X1-McFly/Sim_BCI/old/notes/schematic.pdf

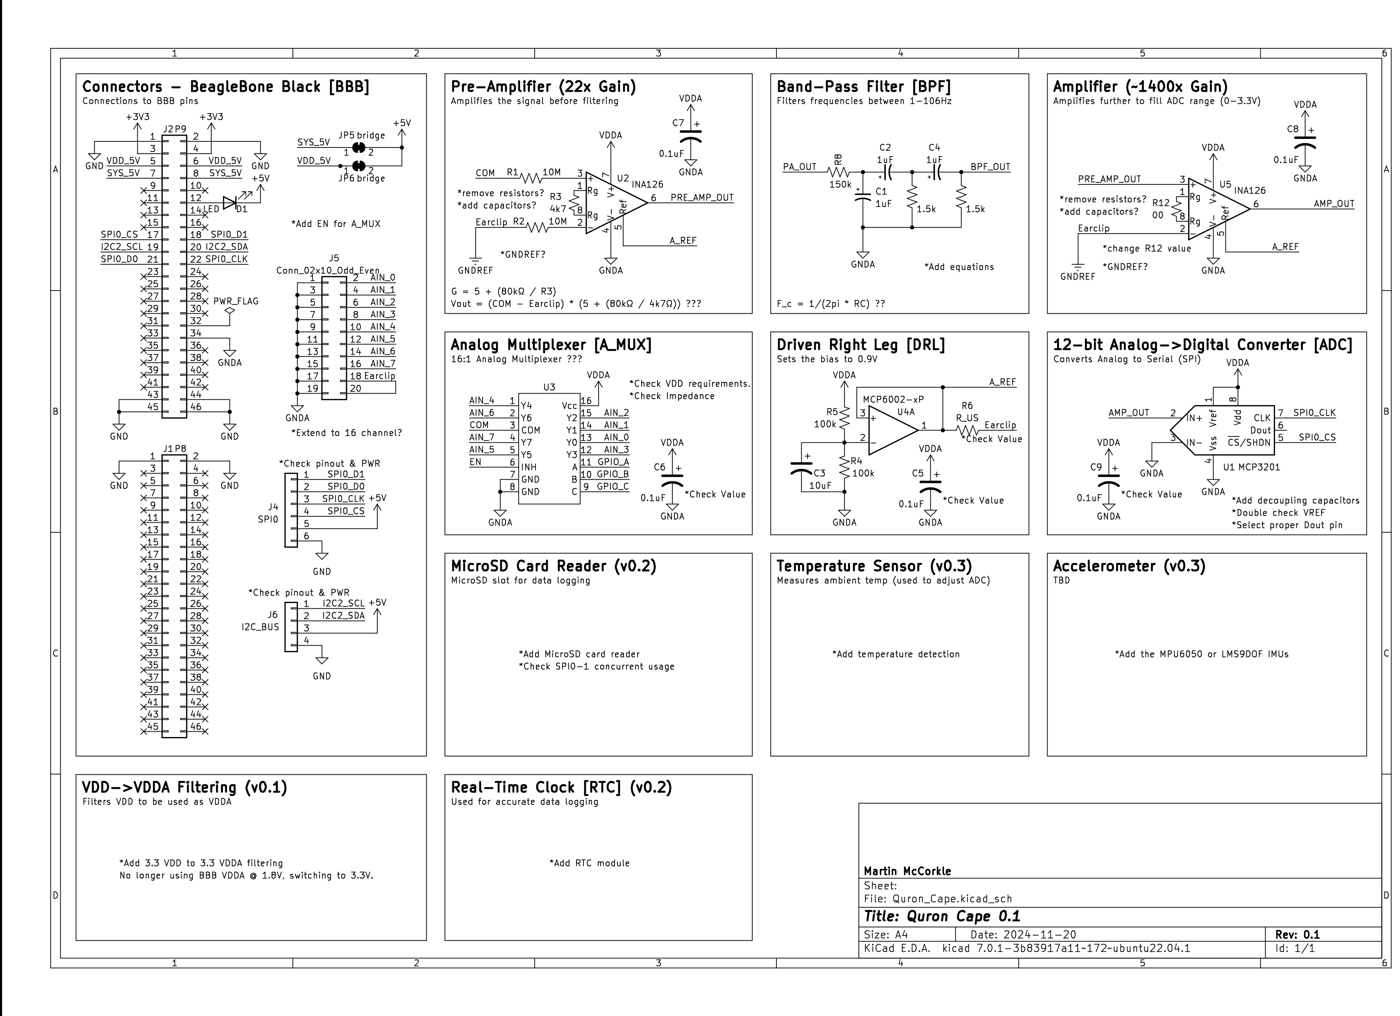
[picture p28: page 1]
