X1-McFly/Sim_BCI/old/hardware/Quron_Capev1/doc/output.pdf

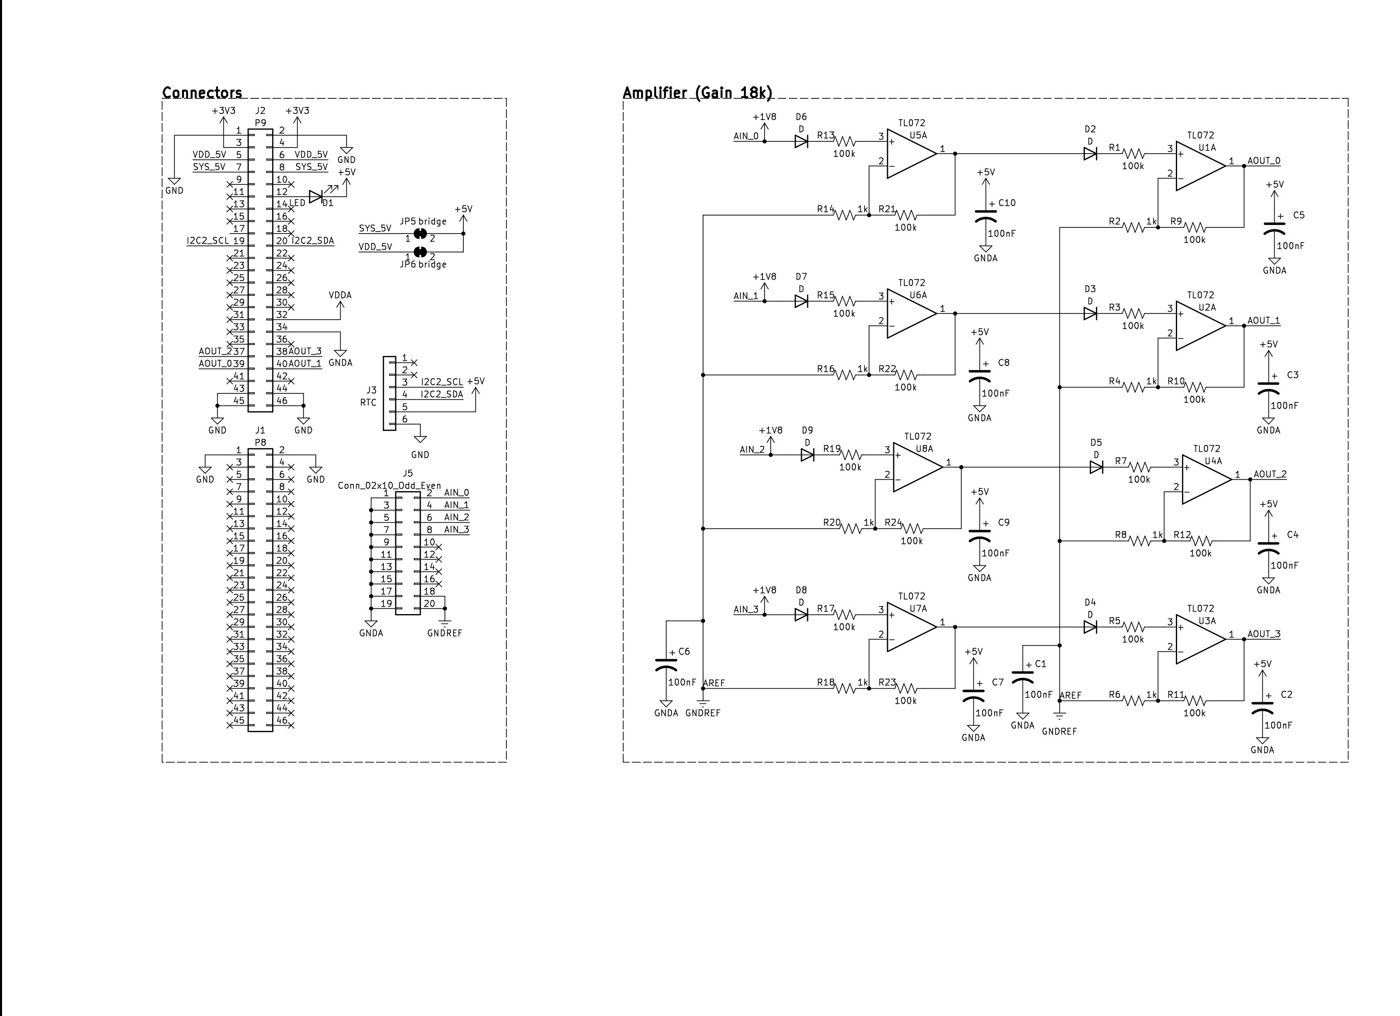
[picture p29: page 1]
