X1-McFly/Sim_BCI/old/hardware/Quron_Capev1/doc/schematic_v1-1.pdf

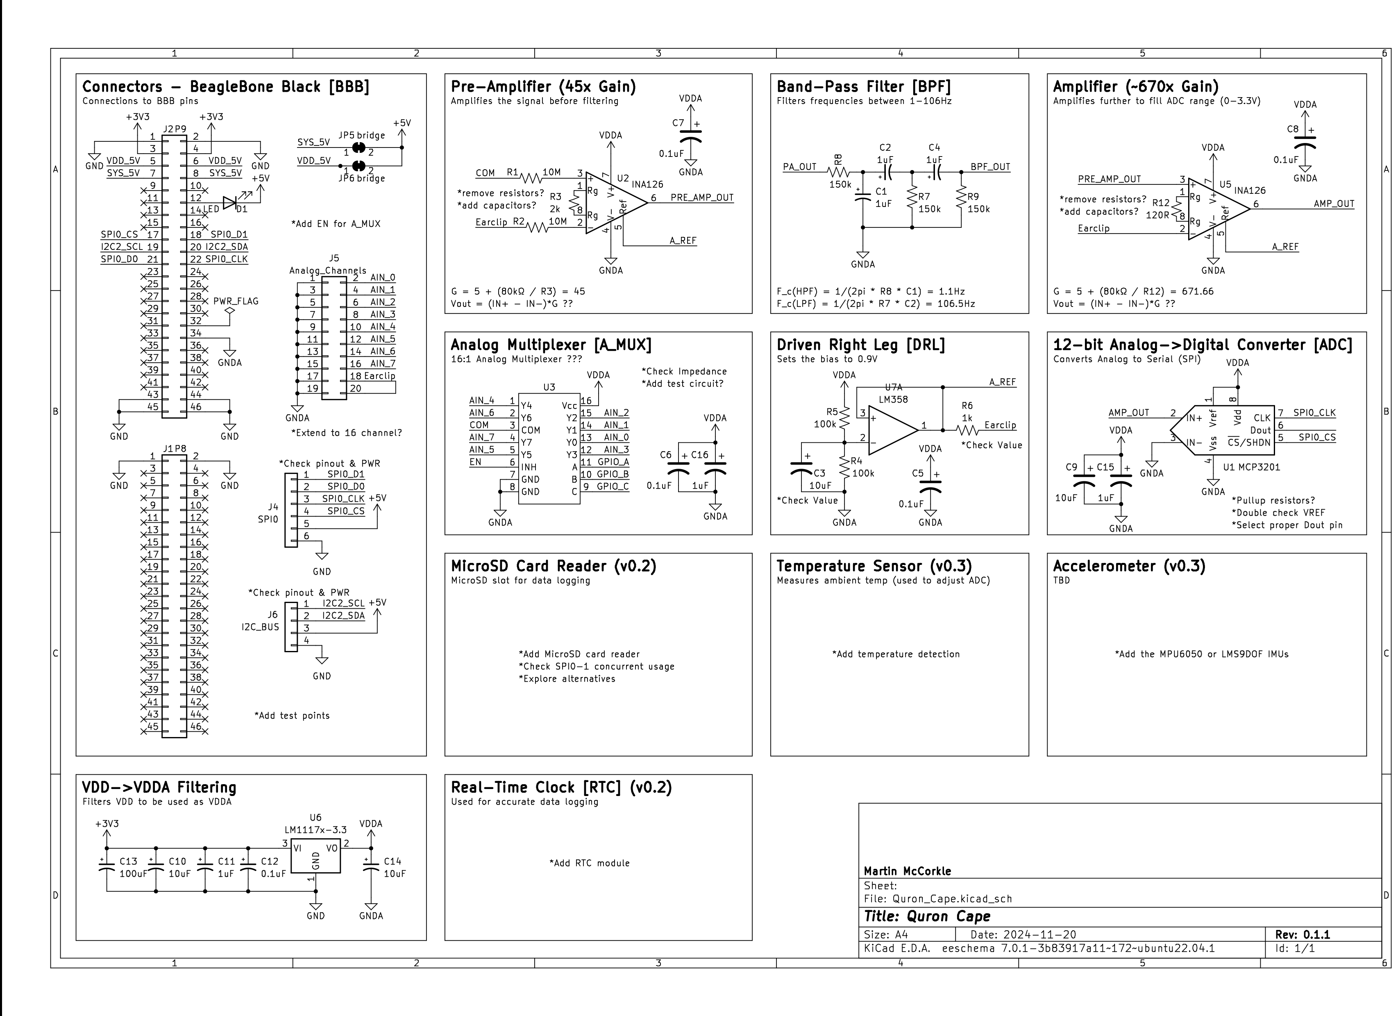
[picture p30: page 1]
