X1-McFly/Sim_BCI/old/hardware/Quron_Capev1/bms/BMS v0.1/output.pdf

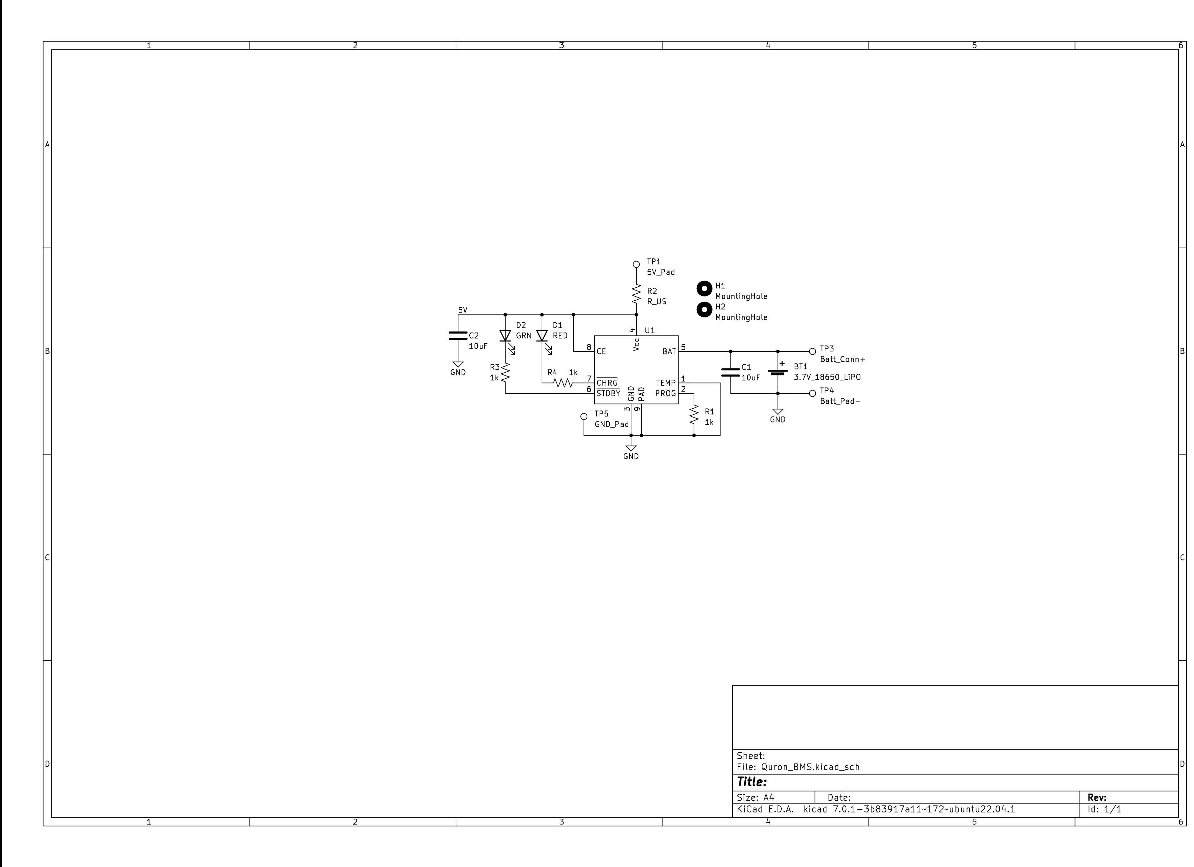
[picture p31: page 1]
