X1-McFly/Sim_BCI/doc/report(11-10-2024)/circuit1.png

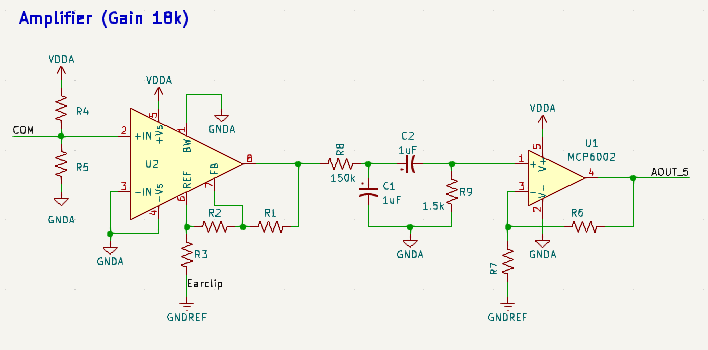
doc/report(11-10-2024)/circuit1.png
