X1-McFly/Sim_BCI/doc/report(11-25-2024)/img/spice-scrnsht(10-14-2024).png

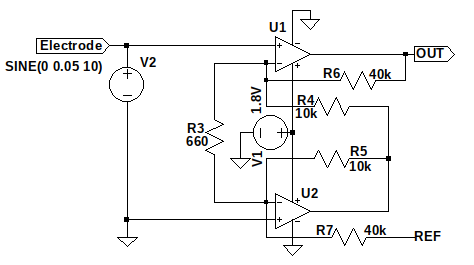
doc/report(11-25-2024)/img/spice-scrnsht(10-14-2024).png
