X1-McFly/Sim_BCI/doc/report(11-25-2024)/oscillo(10-25-24)/TEK00003.PNG

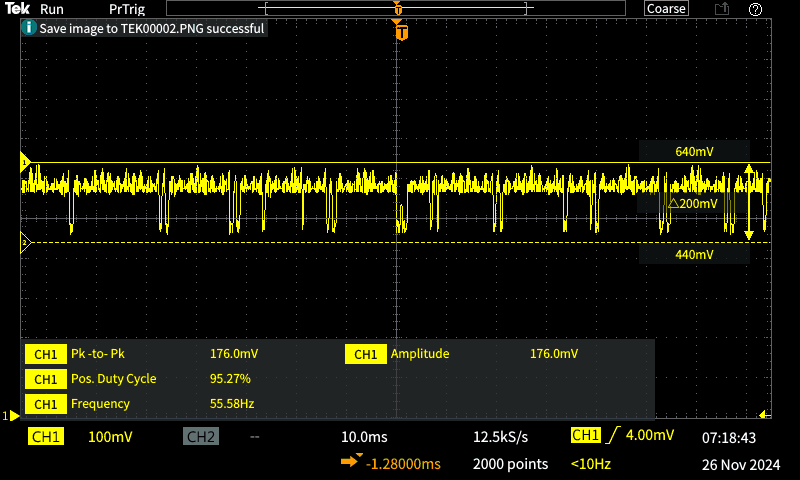
doc/report(11-25-2024)/oscillo(10-25-24)/TEK00003.PNG
