X1-McFly/Sim_BCI/doc/report(12-23-2024)/img/TEK00001.PNG

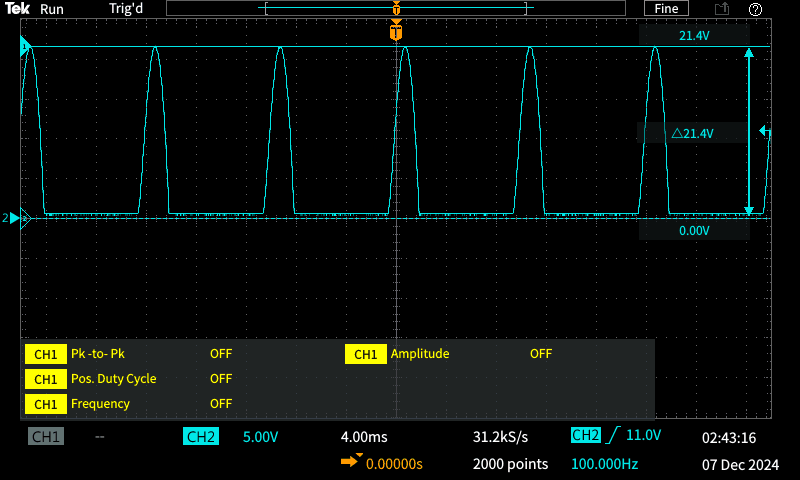
doc/report(12-23-2024)/img/TEK00001.PNG
