X1-McFly/Sim_BCI/doc/report(12-23-2024)/img/TEK00002.PNG

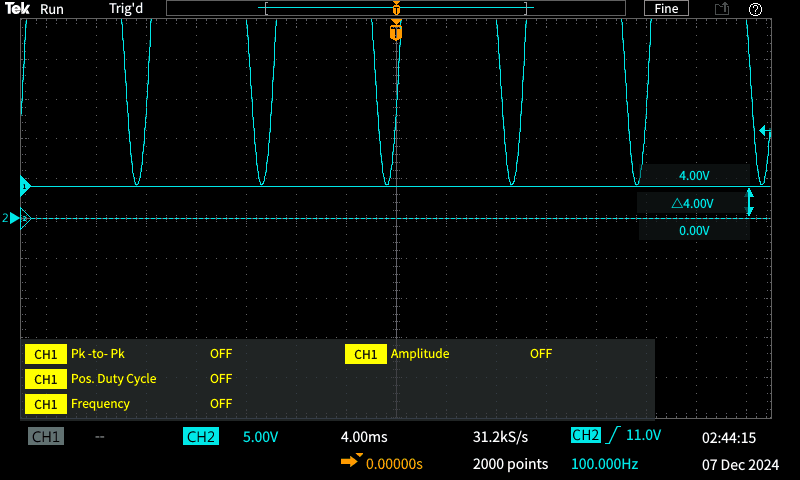
doc/report(12-23-2024)/img/TEK00002.PNG
