X1-McFly/Sim_BCI/img/alpha_fft_vs_steering.png

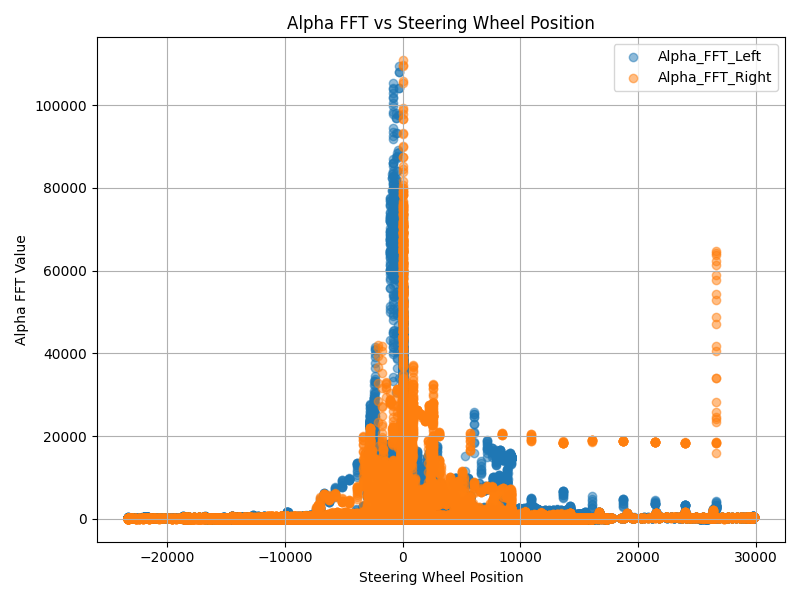
img/alpha_fft_vs_steering.png
