X1-McFly/Sim_BCI/img/eeg_fft_vs_steering_correlation.png

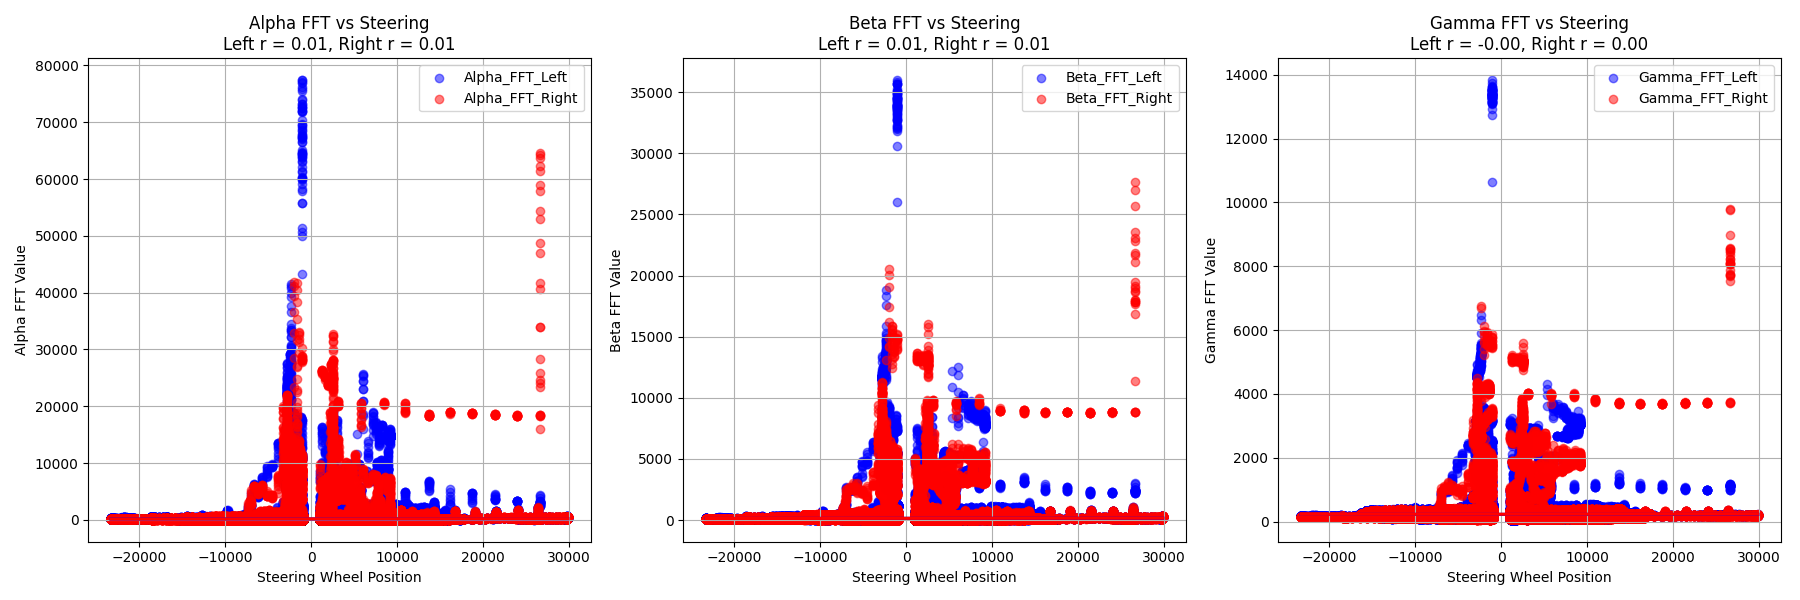
img/eeg_fft_vs_steering_correlation.png
