X1-McFly/Sim_BCI/img/electrode_placement1.png

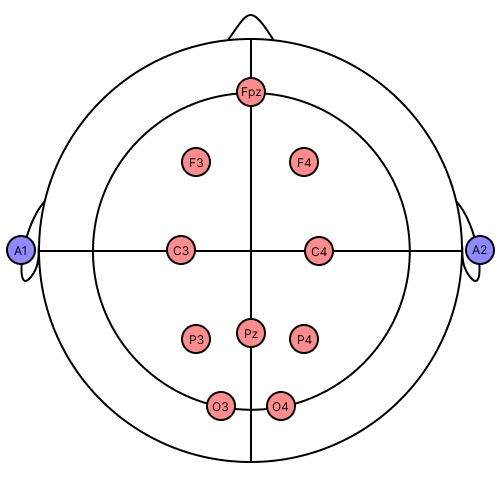
img/electrode_placement1.png
