X1-McFly/Sim_BCI/img/Figure_1.png

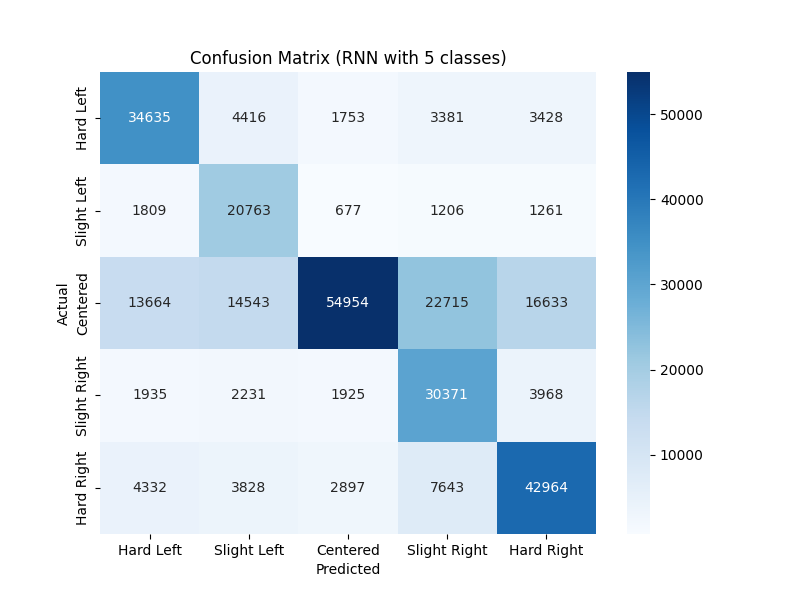
img/Figure_1.png
