X1-McFly/Sim_BCI/img/gamma_fft_vs_steering.png

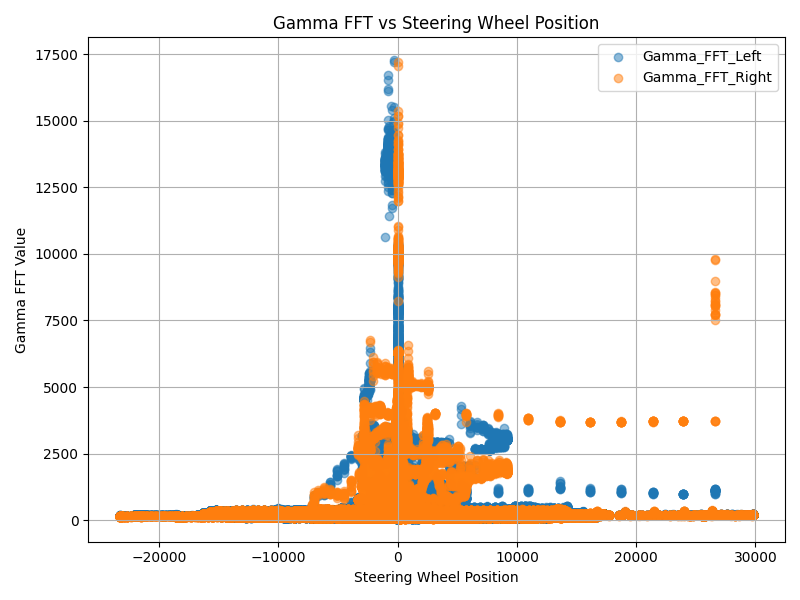
img/gamma_fft_vs_steering.png
