X1-McFly/Sim_BCI/img/plot.png

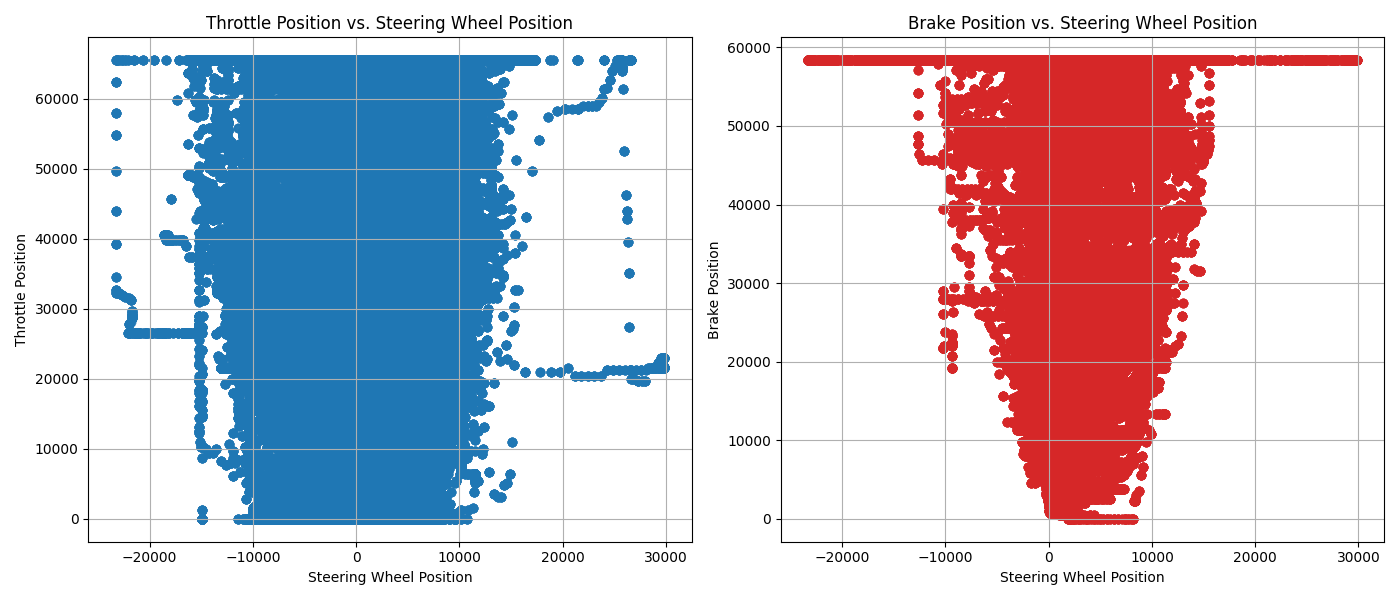
img/plot.png
