X1-McFly/Sim_BCI/img/Screenshot 2025-02-15 232623.png

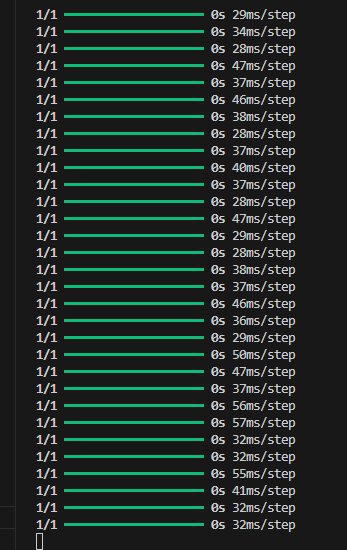
img/Screenshot 2025-02-15 232623.png
