X1-McFly/Sim_BCI/img/Screenshot 2025-02-16 014142.png

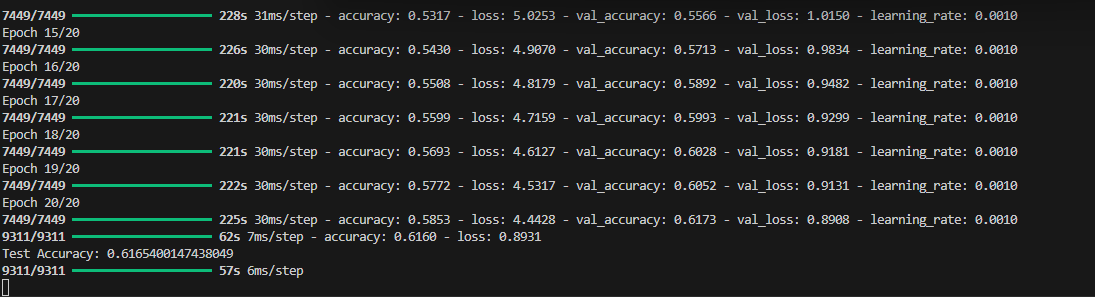
img/Screenshot 2025-02-16 014142.png
