X1-McFly/Sim_BCI/img/Screenshot 2025-03-04 134548.png

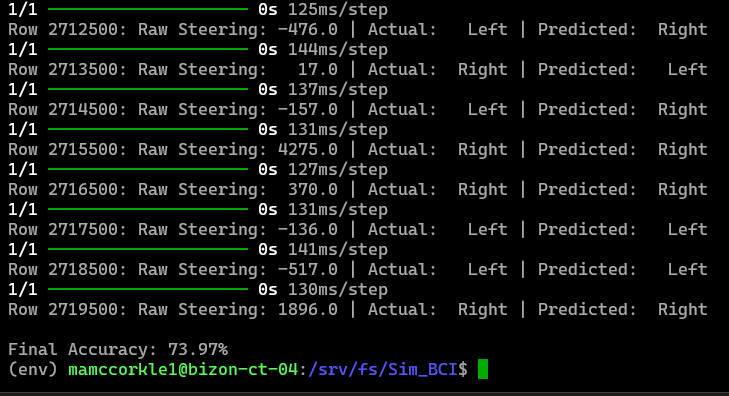
img/Screenshot 2025-03-04 134548.png
