X1-McFly/Sim_BCI/img/Screenshot 2025-03-04 135923.png

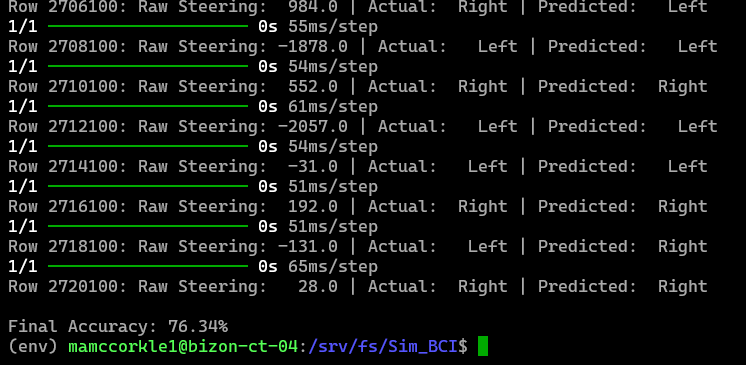
img/Screenshot 2025-03-04 135923.png
