X1-McFly/Sim_BCI/models/model_v0.5/confusion_matrix.png

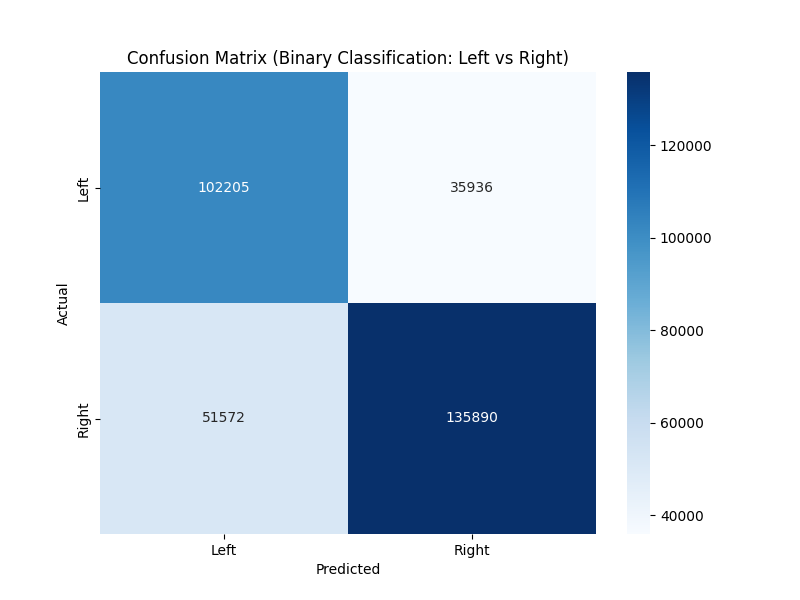
models/model_v0.5/confusion_matrix.png
