X1-McFly/Sim_BCI/old/hardware/Quron_Capev1/quron_enclosure_v0.1/Brain Computer Interface Housing/Part files/Quron BMS Board.SLDPRT

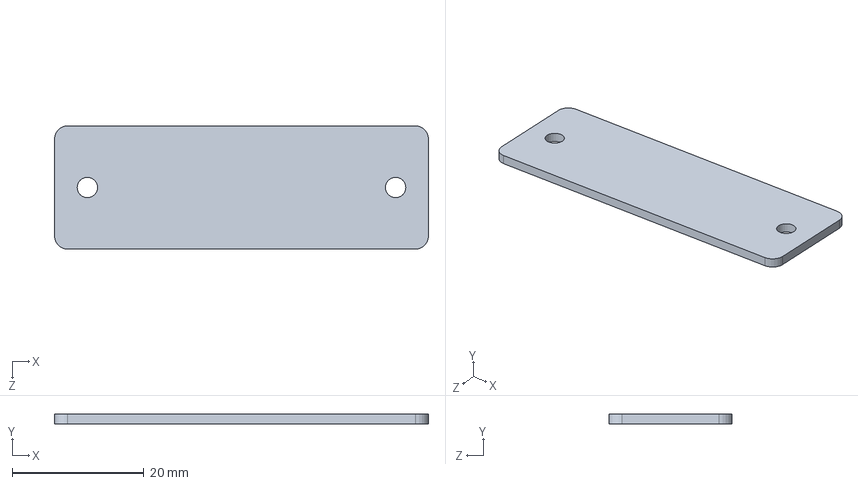
[picture p60: CAD file, 2025-03-06, an earlier design]
old/hardware/Quron_Capev1/quron_enclosure_v0.1/Brain Computer Interface Housing/Part files/Quron BMS Board.SLDPRT
56.9 x 1.50 x 18.8 mm
