X1-McFly/Sim_BCI/old/hardware/Quron_Capev1/quron_enclosure_v0.1/STL Files/Beaglebone Housing CAP Protype 3 GROUP 2.STL

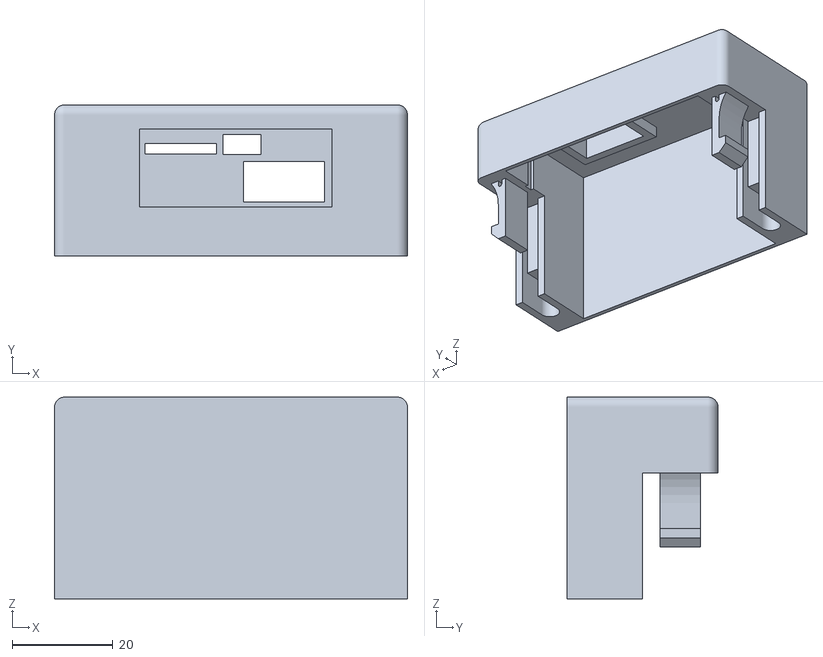
[picture p61: CAD file, 2025-03-06, an earlier design]
old/hardware/Quron_Capev1/quron_enclosure_v0.1/STL Files/Beaglebone Housing CAP Protype 3 GROUP 2.STL
70.0 x 30.0 x 40.0
