X1-McFly/Sim_BCI/old/hardware/Quron_Capev1/quron_enclosure_v0.1/STL Files/Beaglebone Housing Prototype 3 GROUP 2 - MEEG 3379.STL

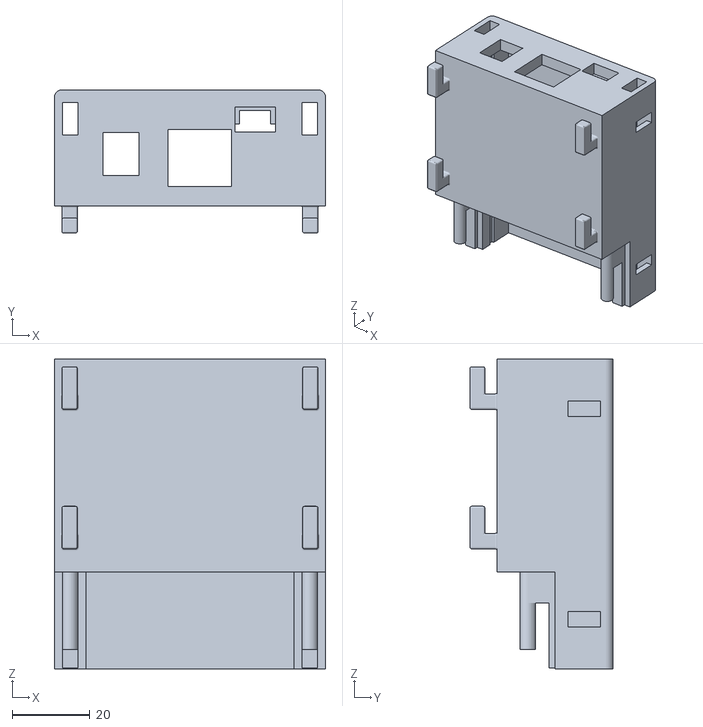
[picture p63: CAD file, 2025-03-06, an earlier design]
old/hardware/Quron_Capev1/quron_enclosure_v0.1/STL Files/Beaglebone Housing Prototype 3 GROUP 2 - MEEG 3379.STL
70.0 x 37.0 x 80.0
