X1-McFly/Sim_BCI/old/hardware/Quron_Capev1/quron_enclosure_v0.1/STL Files/Corner Connector Inside Part.STL

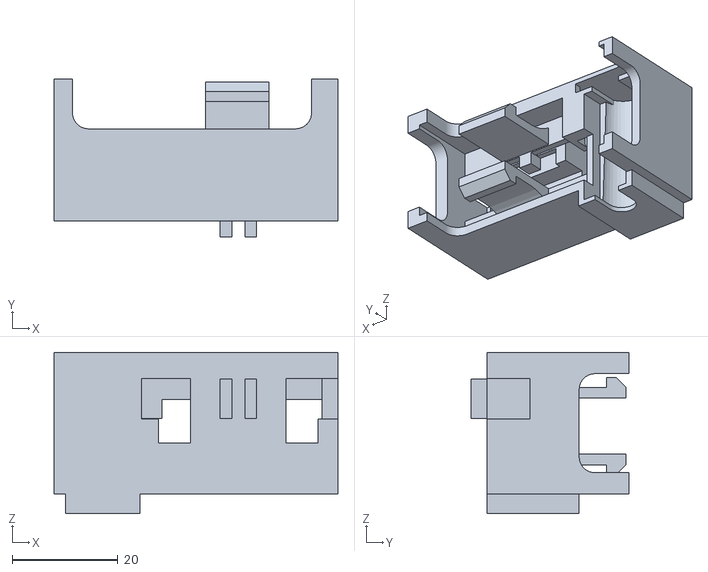
[picture p64: CAD file, 2025-03-06, an earlier design]
old/hardware/Quron_Capev1/quron_enclosure_v0.1/STL Files/Corner Connector Inside Part.STL
53.6 x 29.8 x 30.4
