X1-McFly/Sim_BCI/old/hardware/Quron_Capev1/quron_enclosure_v0.1/STL Files/Corner Connector Housing.STL

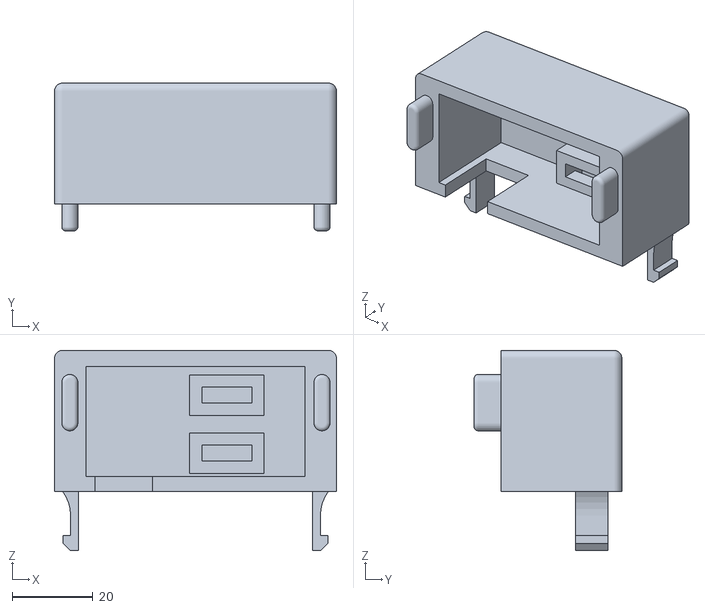
[picture p65: CAD file, 2025-03-06, an earlier design]
old/hardware/Quron_Capev1/quron_enclosure_v0.1/STL Files/Corner Connector Housing.STL
70.0 x 36.7 x 49.8
