X1-McFly/Sim_BCI/old/hardware/Quron_Capev1/quron_enclosure_v0.1/Brain Computer Interface Housing/Part files/Cover.SLDPRT

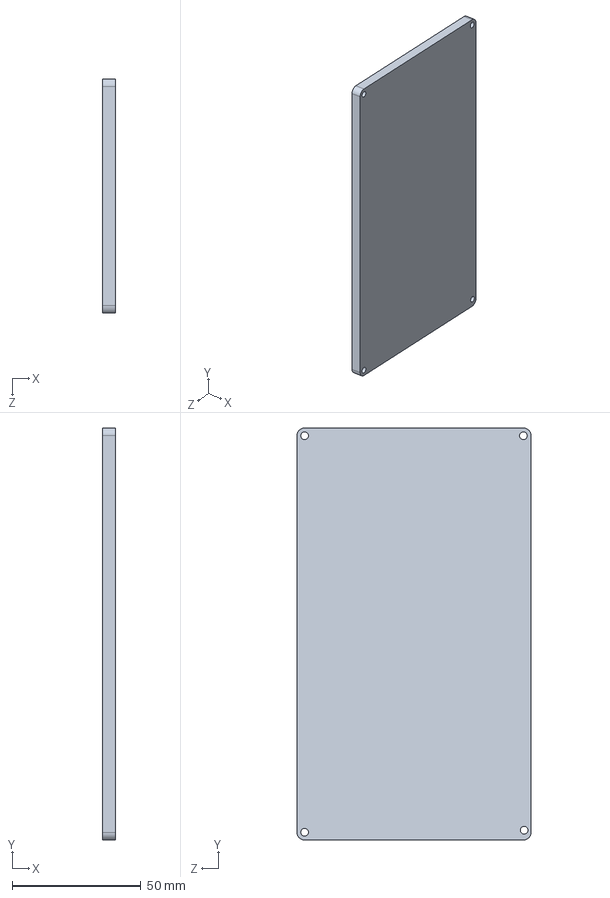
[picture p66: CAD file, 2025-03-06, an earlier design]
old/hardware/Quron_Capev1/quron_enclosure_v0.1/Brain Computer Interface Housing/Part files/Cover.SLDPRT
5.00 x 160.0 x 91.0 mm
