X1-McFly/Sim_BCI/old/hardware/Quron_Capev1/quron_enclosure_v0.1/STL Files/Battery Pack Housing V2.STL

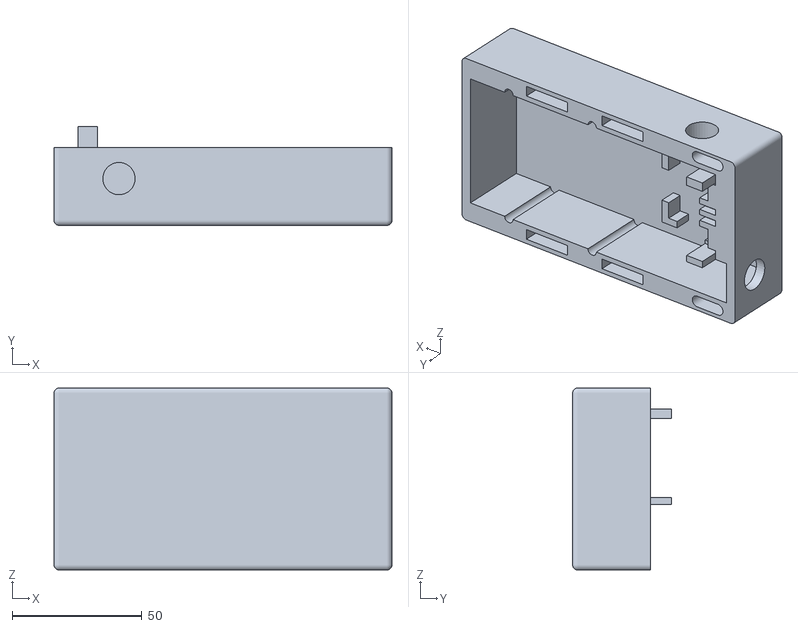
[picture p67: CAD file, 2025-03-06, an earlier design]
old/hardware/Quron_Capev1/quron_enclosure_v0.1/STL Files/Battery Pack Housing V2.STL
130.0 x 38.0 x 70.0
