X1-McFly/Sim_BCI/old/hardware/Quron_Capev1/quron_enclosure_v0.1/Brain Computer Interface Housing/Part files/18650 battery single enclosure.STEP

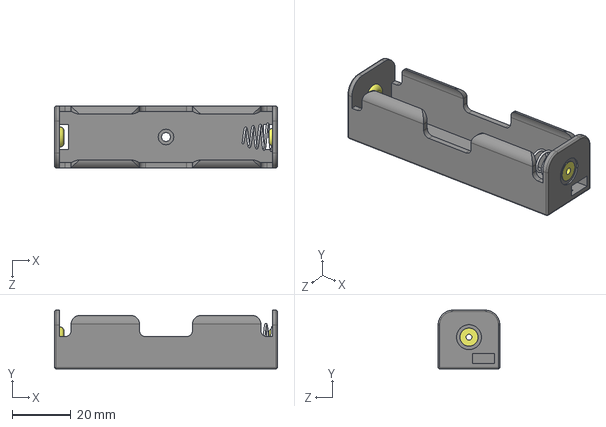
[picture p69: CAD file, 2025-03-06, an earlier design]
old/hardware/Quron_Capev1/quron_enclosure_v0.1/Brain Computer Interface Housing/Part files/18650 battery single enclosure.STEP
75.9 x 20.0 x 21.0 mm
