X1-McFly/Sim_BCI/old/hardware/Quron_Capev1/quron_enclosure_v0.1/Brain Computer Interface Housing/Part files/Assembly.SLDASM

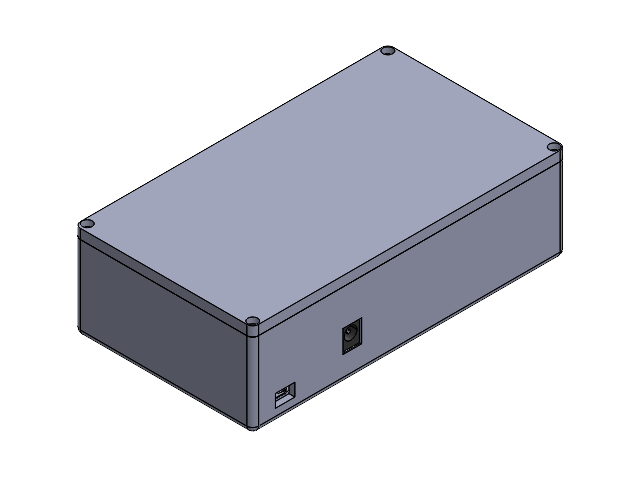
[picture p70: CAD file, 2025-03-06, an earlier design]
old/hardware/Quron_Capev1/quron_enclosure_v0.1/Brain Computer Interface Housing/Part files/Assembly.SLDASM
Housing
BEAGLEBONE_BLACK
18650 battery single enclosure x 3
Quron BMS Board
Cover
