X1-McFly/Sim_BCI/(list of files, cad)

Other CAD files:
old/hardware/Quron_Capev1/quron_enclosure_v0.1/Brain Computer Interface Housing/Drawings/Cover Drawing.SLDDRW
old/hardware/Quron_Capev1/quron_enclosure_v0.1/Brain Computer Interface Housing/Drawings/Housing Drawing.SLDDRW
old/hardware/Quron_Capev1/quron_enclosure_v0.1/Brain Computer Interface Housing/Part files/18650 battery single enclosure.SLDPRT
old/hardware/Quron_Capev1/quron_enclosure_v0.1/Brain Computer Interface Housing/STL Files/Cover.STL
old/hardware/Quron_Capev1/quron_enclosure_v0.1/Brain Computer Interface Housing/STL Files/Housing.STL
