X1-McFly/Sim_BCI/old/code/machine_learning_test/annot-1.csv

 | Start | Duration | Description
0 | 0.0 | 4.2 | T0
1 | 4.2 | 4.1 | T2
2 | 8.3 | 4.2 | T0
3 | 12.5 | 4.1 | T1
4 | 16.6 | 4.2 | T0
5 | 20.8 | 4.1 | T2
6 | 24.9 | 4.2 | T0
7 | 29.1 | 4.1 | T1
8 | 33.2 | 4.2 | T0
9 | 37.4 | 4.1 | T1
10 | 41.5 | 4.2 | T0
11 | 45.7 | 4.1 | T2
12 | 49.8 | 4.2 | T0
13 | 54.0 | 4.1 | T1
14 | 58.1 | 4.2 | T0
15 | 62.3 | 4.1 | T2
16 | 66.4 | 4.2 | T0
17 | 70.6 | 4.1 | T1
18 | 74.7 | 4.2 | T0
19 | 78.9 | 4.1 | T2
20 | 83.0 | 4.2 | T0
21 | 87.2 | 4.1 | T2
22 | 91.3 | 4.2 | T0
23 | 95.5 | 4.1 | T1
24 | 99.6 | 4.2 | T0
25 | 103.8 | 4.1 | T2
26 | 107.9 | 4.2 | T0
27 | 112.1 | 4.1 | T1
28 | 116.2 | 4.2 | T0
29 | 120.4 | 4.1 | T2
