X1-McFly/Sim_BCI/old/code/machine_learning_test/data.csv

 | Fpz | F3 | F4 | C3 | C4 | P3 | Pz | P4 | O1 | O2 | Annotations
0 | 9.9e-05 | -1.1e-05 | 5.8e-05 | 5.8e-05 | 5.8e-05 | 1.6e-05 | 6.599999999999999e-05 | 3.9e-05 | 2.9e-05 | 5.9e-05 | 0
1 | 0.000107 | -1.6e-05 | 6.2e-05 | 6.1e-05 | 5e-05 | 3.2999999999999996e-05 | 7.099999999999999e-05 | 4.4e-05 | 3.2e-05 | 6.9e-05 | 0
2 | 0.000116 | -2.5e-05 | 4.5e-05 | 6.7e-05 | 3.9e-05 | 1.4e-05 | 4.3e-05 | 2.4e-05 | 2.5e-05 | 6.5e-05 | 0
3 | 9.6e-05 | -3.9e-05 | 3.4e-05 | 3.5e-05 | 2e-05 | -3e-06 | 3e-05 | 1.6e-05 | 1.3e-05 | 5e-05 | 0
4 | 9.700000000000001e-05 | -3.2e-05 | 5e-05 | 3.5e-05 | 3e-05 | 2.1e-05 | 5e-05 | 2.9e-05 | 1.4999999999999999e-05 | 4.4e-05 | 0
5 | 0.000112 | -2.5e-05 | 4.8e-05 | 6.5e-05 | 3.2999999999999996e-05 | 4.4e-05 | 6.1e-05 | 2.9e-05 | 3.6e-05 | 5.8e-05 | 0
6 | 0.000107 | -4.6e-05 | 2.9e-05 | 7.099999999999999e-05 | 1.6e-05 | 2.5e-05 | 4.3e-05 | 7.999999999999998e-06 | 4.3e-05 | 6e-05 | 0
7 | 8.899999999999998e-05 | -6.3e-05 | 1.4e-05 | 4.5e-05 | -2e-06 | 6e-06 | 3.1e-05 | 1.0000000000000002e-06 | 3.1e-05 | 4.6e-05 | 0
8 | 7.399999999999998e-05 | -5.9e-05 | 1.2e-05 | 3.4e-05 | -7.999999999999998e-06 | 1.4e-05 | 4.8e-05 | 1.7e-05 | 2.7e-05 | 4.1e-05 | 0
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
