X1-McFly/Sim_BCI/old/code/machine_learning_test/target_data.csv

 | Fpz | F3 | F4 | C3 | C4 | P3 | Pz | P4 | O1 | O2 | Annotations
0 | -0.000157 | -0.000117 | -9.700000000000001e-05 | -6.4e-05 | -7.8e-05 | -0.000103 | -9.700000000000001e-05 | -9.700000000000001e-05 | -7.099999999999999e-05 | -5.9e-05 | 0
1 | -8.6e-05 | -0.000109 | -8.799999999999998e-05 | -6.8e-05 | -0.000104 | -9.9e-05 | -9.700000000000001e-05 | -0.000104 | -7.899999999999998e-05 | -6.3e-05 | 0
2 | -8.999999999999998e-05 | -0.000114 | -0.000102 | -7.099999999999999e-05 | -0.000105 | -7.3e-05 | -7.599999999999999e-05 | -8.2e-05 | -6.8e-05 | -4.5e-05 | 0
3 | -0.0001 | -0.000118 | -9.9e-05 | -6.4e-05 | -9.700000000000001e-05 | -8.2e-05 | -9.1e-05 | -9.5e-05 | -5.8e-05 | -2.9e-05 | 0
4 | -0.000122 | -0.000133 | -0.000118 | -6.8e-05 | -0.000116 | -6.7e-05 | -9.2e-05 | -0.0001 | -5e-05 | -2.5e-05 | 0
5 | -0.000143 | -0.00013099999999999999 | -0.000121 | -4.7e-05 | -0.000124 | -6.1e-05 | -8.099999999999999e-05 | -8.899999999999998e-05 | -5e-05 | -4e-05 | 0
6 | -0.000105 | -0.000101 | -8.7e-05 | -3e-05 | -9.5e-05 | -3.4e-05 | -4.5e-05 | -4.8e-05 | -3.4e-05 | -2.8e-05 | 0
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
