X1-McFly/Sim_BCI/old/notes/Concept map.pdf

## Electronics

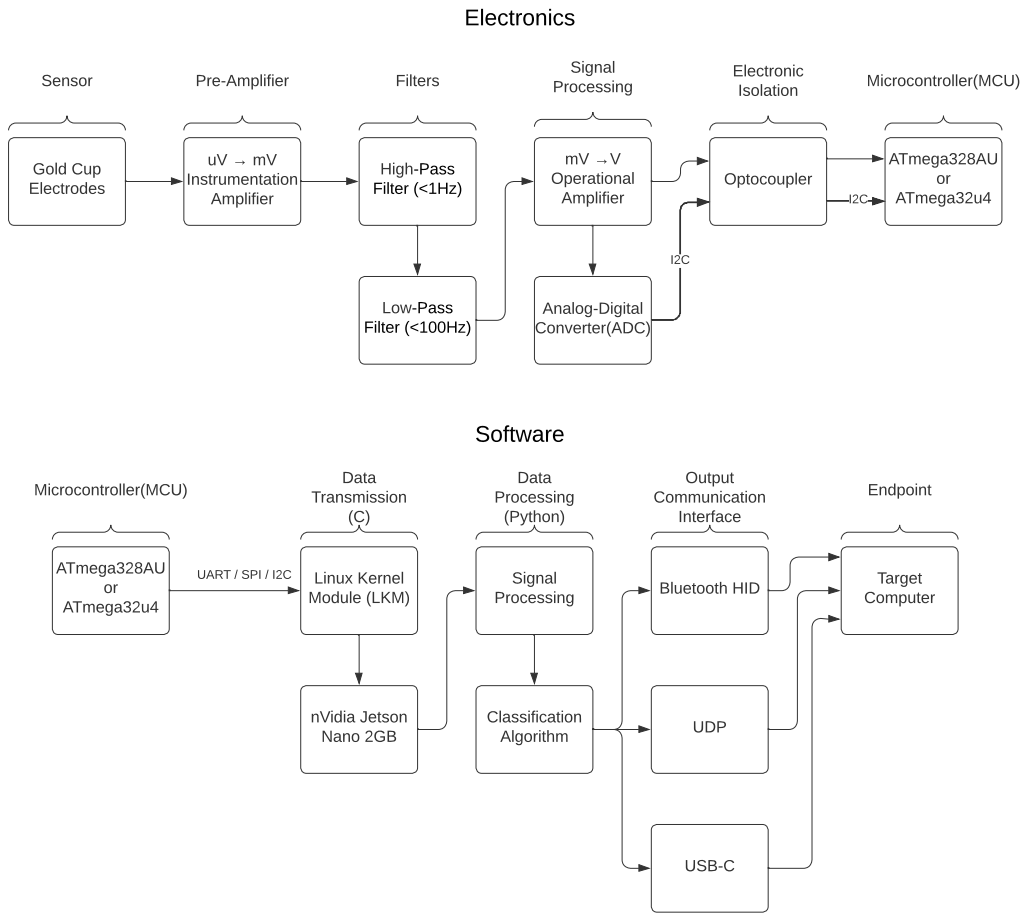
[picture p71: page 1]
High-Pass Filter (<1Hz); Gold Cup Electrodes; mV ? V Operational Amplifier; Analog-Digital Converter(ADC); ATmega328AU or ATmega32u4; Low-Pass Filter (<100Hz); uV ? mV Instrumentation Amplifier; Optocoupler; Sensor; Pre-Amplifier; Filters; Microcontroller(MCU) Electronic; Isolation; Signal Processing; Software; Microcontroller(MCU); UART / SPI / I2C; nVidia Jetson Nano 2GB; Linux Kernel Module (LKM); Classification Algorithm; Bluetooth HID; Data Transmission (C); UDP; Target Computer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
